teeheee/puzzle-box/layout/puzzlebox.ods

Id | Designator | Package | Quantity | Designation | Supplier and ref
23 | U1 | LQFP-48_7x7mm_P0.5mm | 1 | STM32F103C8Tx | https://www.reichelt.de/arm-cortex-m3-mikrocontroller-32-bit-2v-16-kb-lqfp-48-stm32f103c4t6a-p263735.html
25 | U3 | SOT-23-5 | 1 | MCP73831 | https://www.reichelt.de/battery-management-ic-li-ion-sot-23-5-mcp-73831t-2aci-p217314.html?trstct=pos_3
27 | U5 | Bosch_LGA-8_2.5x2.5mm_P0.65mm_ClockwisePinNumbering | 1 | BME280 | https://www.reichelt.de/kombo-sensor-luftdruck-luftfeuchtigkeit-temp-bme-280-p159825.html?trstct=pos_0
28 | U6 | LGA-12_2x2mm_P0.5mm | 1 | LSM303C | https://de.aliexpress.com/item/32954201739.html
31 | Q2,Q3,Q4 | BSS138 | 3 | Q_PMOS_DGS | https://www.reichelt.de/mosfet-p-ch-60v-0-33a-0-36w-sot-23-bss-83p-smd-p41442.html?&trstct=pos_0
