teeheee/puzzle-box/layout/stencil/puzzlebox-Edge.Cuts.dxf

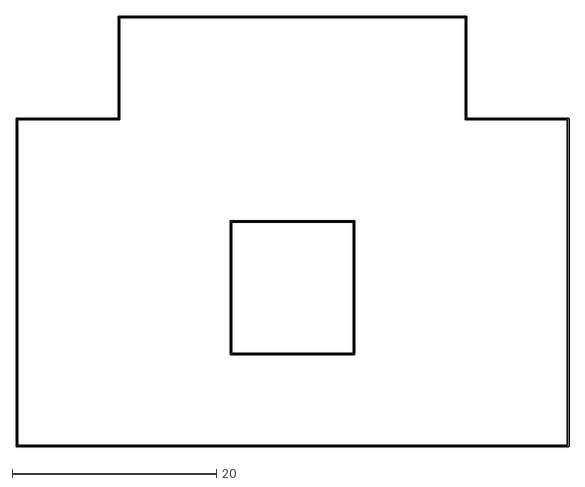
[picture p1: CAD file, 2019-11-30]
layout/stencil/puzzlebox-Edge.Cuts.dxf
54.2 x 42.2
