teeheee/puzzle-box/(list of files, cad)

Other CAD files:
layout/stencil/puzzlebox-B.Paste.dxf
layout/stencil/puzzlebox-F.Paste.dxf
