teeheee/puzzle-box/layout/puzzlebox.kicad_pcb

## KiCad design layout/puzzlebox.kicad_pcb (2019-11-03)

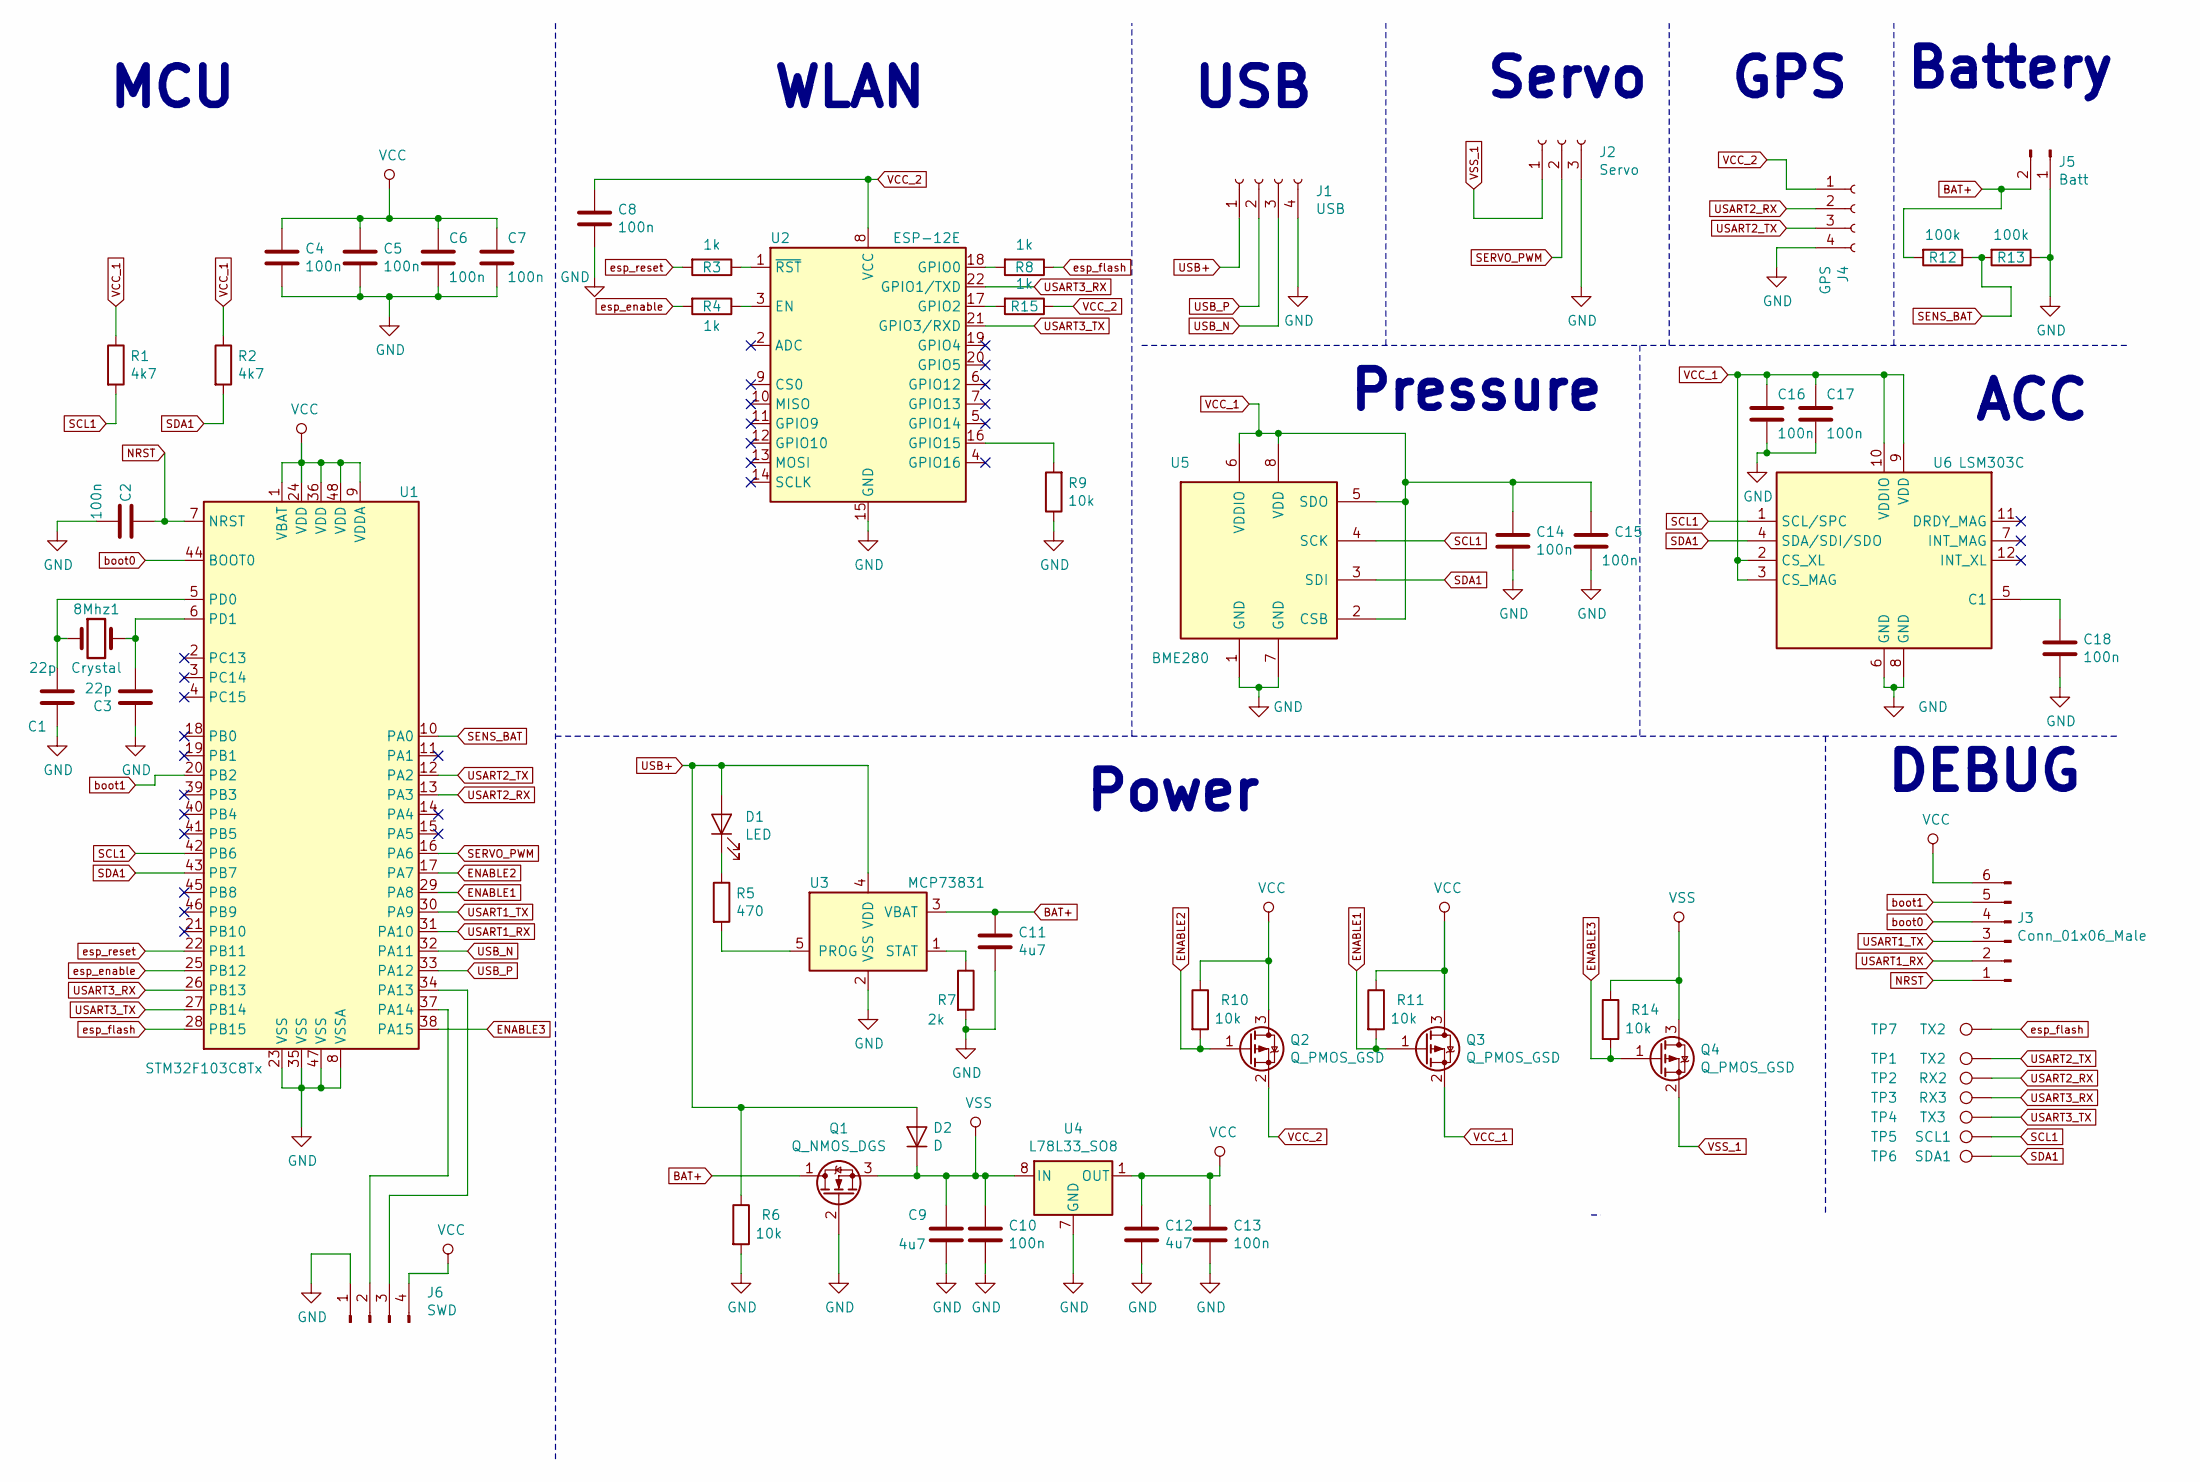
[picture p2: schematic puzzlebox.sch]

Parts:
8Mhz1: Crystal; Crystal_SMD_HC49-SD
C1, C3: 22p; C_0805_2012Metric
C2, C4, C5, C6, C7, C8, C10, C13, C14, C15, C16, C17, C18: 100n; C_0805_2012Metric
C9, C11, C12: 4u7; C_0805_2012Metric
D1: LED; LED_1206_3216Metric
D2: D; D_SOD-123
J1: USB; PinHeader_1x04_P1.00mm_Vertical
J2: Servo; PinHeader_1x03_P1.00mm_Vertical
J3: Conn_01x06_Male; PinHeader_2x03_P2.54mm_Vertical
J4: GPS; PinHeader_1x04_P1.00mm_Vertical
J5: Batt; PinHeader_1x02_P2.54mm_Vertical
J6: SWD; PinHeader_1x04_P2.00mm_Horizontal
Q1: Q_NMOS_DGS; BSS138
Q2, Q3, Q4: Q_PMOS_GSD; BSS138
R1, R2: 4k7; R_0805_2012Metric
R3, R4, R8, R15: 1k; R_0805_2012Metric
R5: 470; R_0805_2012Metric
R6, R9, R10, R11, R14: 10k; R_0805_2012Metric
R7: 2k; R_0805_2012Metric
R12, R13: 100k; R_0805_2012Metric
TP1, TP7: TX2; TestPoint_Pad_D2.0mm
TP2: RX2; TestPoint_Pad_D2.0mm
TP3: RX3; TestPoint_Pad_D2.0mm
TP4: TX3; TestPoint_Pad_D2.0mm
TP5: SCL1; TestPoint_Pad_D2.0mm
TP6: SDA1; TestPoint_Pad_D2.0mm
U1: STM32F103C8Tx; LQFP-48_7x7mm_P0.5mm
U2: ESP-12E
U3: MCP73831; SOT-23-5
U4: L78L33_SO8; SOIC-8_3.9x4.9mm_P1.27mm
U5: BME280; Bosch_LGA-8_2.5x2.5mm_P0.65mm_ClockwisePinNumbering
U6: LSM303C; LGA-12_2x2mm_P0.5mm

Connections:
BAT+: C11.1, J5.2, Q1.1 (D), R12.2, U3.3 (VBAT)
ENABLE1: Q3.1 (G), R11.2, U1.29 (PA8)
ENABLE2: Q2.1 (G), R10.2, U1.17 (PA7)
ENABLE3: Q4.1 (G), R14.2, U1.38 (PA15)
GND: C1.1, C2.2, C3.1, C4.2, C5.2, C6.2, C7.2, C8.2, C9.2, C10.2, C11.2, C12.2, C13.2, C14.2, C15.2, C16.2, C17.2, C18.2, J1.4, J2.3, J4.4, J5.1, J6.1, Q1.2 (G), R6.2, R7.2, R9.1, R13.1, U1.8 (VSSA), U1.23 (VSS), U1.35 (VSS), U1.47 (VSS), U2.15 (GND), U3.2 (VSS), U4.2 (GND), U4.3 (GND), U4.6 (GND), U4.7 (GND), U5.1 (GND), U5.7 (GND), U6.6 (GND), U6.8 (GND)
NRST: C2.1, J3.1, U1.7 (NRST)
unnamed: 8Mhz1.1, C1.2, U1.5 (PD0)
unnamed: 8Mhz1.2, C3.2, U1.6 (PD1)
unnamed: C18.1, U6.5 (C1)
unnamed: D1.1 (K), R5.1
unnamed: J6.2, U1.37 (PA14)
unnamed: J6.3, U1.34 (PA13)
unnamed: R3.1, U2.1 (~RST)
unnamed: R4.1, U2.3 (EN)
unnamed: R5.2, U3.5 (PROG)
unnamed: R7.1, U3.1 (STAT)
unnamed: R8.2, U2.18 (GPIO0)
unnamed: R9.2, U2.16 (GPIO15)
unnamed: R15.2, U2.17 (GPIO2)
SCL1: R1.2, TP5.1, U1.42 (PB6), U5.4 (SCK), U6.1 (SCL/SPC)
SDA1: R2.2, TP6.1, U1.43 (PB7), U5.3 (SDI), U6.4 (SDA/SDI/SDO)
SENS_BAT: R12.1, R13.2, U1.10 (PA0)
SERVO_PWM: J2.2, U1.16 (PA6)
USART1_RX: J3.2, U1.31 (PA10)
USART1_TX: J3.3, U1.30 (PA9)
USART2_RX: J4.2, TP2.1, U1.13 (PA3)
USART2_TX: J4.3, TP1.1, U1.12 (PA2)
USART3_RX: TP3.1, U1.26 (PB13), U2.22 (GPIO1/TXD)
USART3_TX: TP4.1, U1.27 (PB14), U2.21 (GPIO3/RXD)
USB+: D1.2 (A), D2.2 (A), J1.1, R6.1, U3.4 (VDD)
USB_N: J1.3, U1.32 (PA11)
USB_P: J1.2, U1.33 (PA12)
VCC: C4.1, C5.1, C6.1, C7.1, C12.1, C13.1, J3.6, J6.4, Q2.3 (D), Q3.3 (D), R10.1, R11.1, U1.1 (VBAT), U1.9 (VDDA), U1.24 (VDD), U1.36 (VDD), U1.48 (VDD), U4.1 (OUT)
VCC_1: C14.1, C15.1, C16.1, C17.1, Q3.2 (S), R1.1, R2.1, U5.2 (CSB), U5.5 (SDO), U5.6 (VDDIO), U5.8 (VDD), U6.2 (CS_XL), U6.3 (CS_MAG), U6.9 (VDD), U6.10 (VDDIO)
VCC_2: C8.1, J4.1, Q2.2 (S), R15.1, U2.8 (VCC)
VSS: C9.1, C10.1, D2.1 (K), Q1.3 (S), Q4.3 (D), R14.1, U4.8 (IN)
VSS_1: J2.1, Q4.2 (S)
boot0: J3.4, U1.44 (BOOT0)
boot1: J3.5, U1.20 (PB2)
esp_enable: R4.2, U1.25 (PB12)
esp_flash: R8.1, TP7.1, U1.28 (PB15)
esp_reset: R3.2, U1.22 (PB11)

Notes on the sheet:
WLAN
GPS
MCU
Battery
USB
Power
Pressure
Servo
ACC
DEBUG

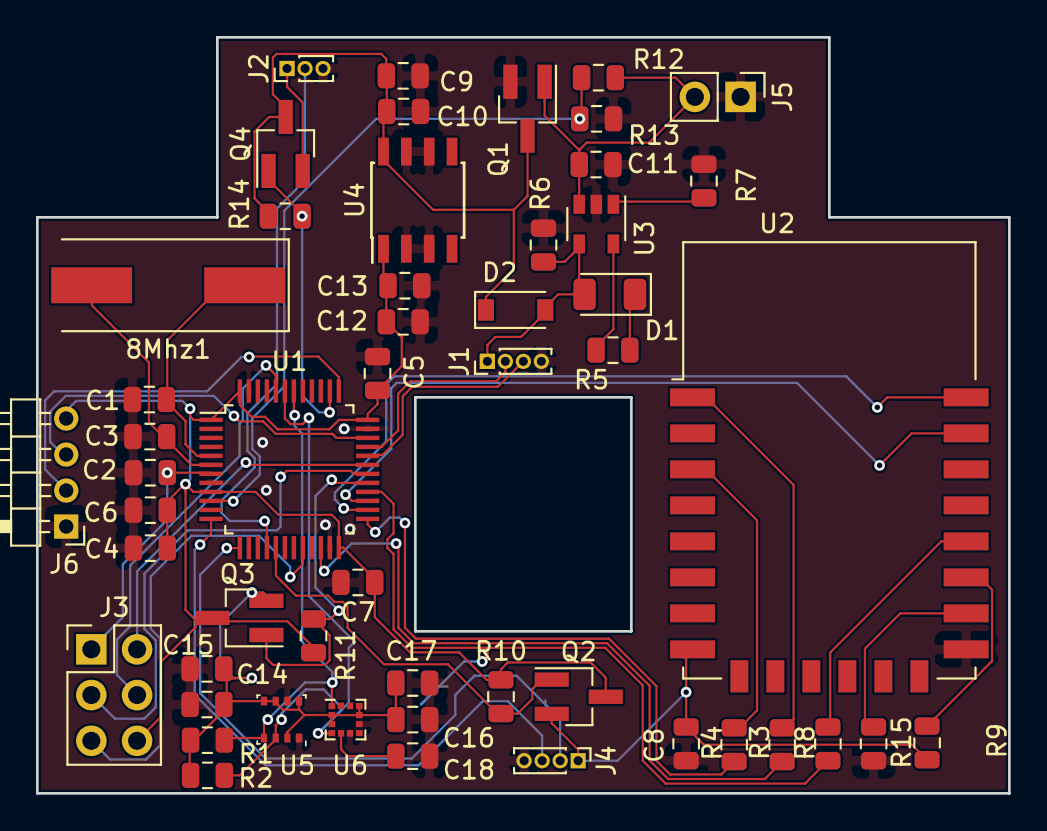
[picture p3: board puzzlebox.kicad_pcb from above]

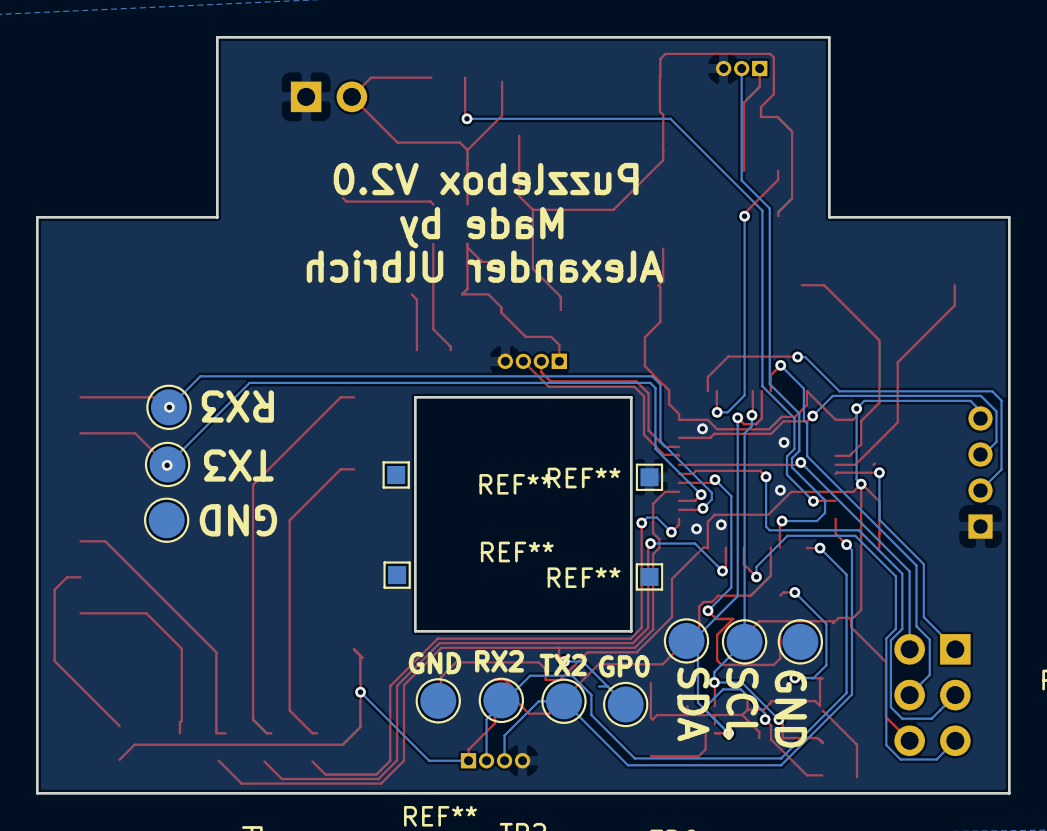
[picture p4: board puzzlebox.kicad_pcb from below]

Board: 2 copper layers, 54.0 x 42.0 mm, 59 parts (7 on the bottom side), 42 nets.
