teeheee/puzzle-box/(threads)

Thread 1 (2019-12-22):

voltage regulater package problem

teeheee, 2019-12-22:
The voltage regulator U4 has the wrong pinout of the package. This issue can be fixed by scraping off the ground connection and soldering a bridge between pin 4 and 5.

TODO: When doing this also update the part naming

Thread 2 (2019-12-22):

esp8266 uart connected wrong

teeheee, 2019-12-22:
The usart3 is connected to the wrong pins of the stm32 mcu.
