teeheee/puzzle-box/firmware/stm32/Src/main.c

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

/* Includes ------------------------------------------------------------------*/
#include "main.h"

ADC_HandleTypeDef hadc1;

I2C_HandleTypeDef hi2c1;

UART_HandleTypeDef huart1;
UART_HandleTypeDef huart2;

void SystemClock_Config(void);
static void MX_GPIO_Init(void);
static void MX_ADC1_Init(void);
static void MX_I2C1_Init(void);
static void MX_USART1_UART_Init(void);
static void MX_USART2_UART_Init(void);
/* USER CODE BEGIN PFP */

void open(void);
void close(void);
void enable_esp8266(void);

/* USER CODE END PFP */

/* USER CODE BEGIN 0 */

void open(void)
{
	HAL_GPIO_WritePin(GPIOA, GPIO_PIN_15, GPIO_PIN_RESET);
    HAL_Delay(100);
    for(int i = 0; i < 50; i++)
    {
		HAL_GPIO_WritePin(GPIOA, GPIO_PIN_6, GPIO_PIN_SET);
	    HAL_Delay(2);
		HAL_GPIO_WritePin(GPIOA, GPIO_PIN_6, GPIO_PIN_RESET);
	    HAL_Delay(18);
    }
	HAL_GPIO_WritePin(GPIOA, GPIO_PIN_15, GPIO_PIN_SET);
}


void close(void)
{
	HAL_GPIO_WritePin(GPIOA, GPIO_PIN_15, GPIO_PIN_RESET);
    HAL_Delay(100);
    for(int i = 0; i < 50; i++)
    {
		HAL_GPIO_WritePin(GPIOA, GPIO_PIN_6, GPIO_PIN_SET);
	    HAL_Delay(1);
		HAL_GPIO_WritePin(GPIOA, GPIO_PIN_6, GPIO_PIN_RESET);
	    HAL_Delay(19);
    }
	HAL_GPIO_WritePin(GPIOA, GPIO_PIN_15, GPIO_PIN_SET);
}

void enable_esp8266(void)
{
	HAL_GPIO_WritePin(GPIOB, GPIO_PIN_11, GPIO_PIN_RESET);
	HAL_GPIO_WritePin(GPIOB, GPIO_PIN_12, GPIO_PIN_SET);
	HAL_GPIO_WritePin(GPIOB, GPIO_PIN_15, GPIO_PIN_SET);
}

void process_esp8266_uart(void)
{
	const char* code = "open";
	static int index = 0;
	uint8_t buffer;
    HAL_UART_Receive(&huart2, &buffer, 1, HAL_MAX_DELAY);
    if(code[index] == buffer)
    	index++;
    else if(code[0] == buffer)
    	index = 1;
    else
    	index = 0;

    if(index == 3)
    	open();
}

/* USER CODE END 0 */

/**
  * @brief  The application entry point.
  * @retval int
  */
int main(void)
{
  

  /* MCU Configuration--------------------------------------------------------*/

  /* Reset of all peripherals, Initializes the Flash interface and the Systick. */
  HAL_Init();

  /* Configure the system clock */
  SystemClock_Config();

  /* Initialize all configured peripherals */
  MX_GPIO_Init();
  MX_ADC1_Init();
  MX_I2C1_Init();
  MX_USART1_UART_Init();
  MX_USART2_UART_Init();
  /* USER CODE BEGIN 2 */
  close();
  enable_esp8266();
  /* USER CODE END 2 */

  /* Infinite loop */
  /* USER CODE BEGIN WHILE */
  while (1)
  {
	  /* USER CODE END WHILE */
	  process_esp8266_uart();
	  /* USER CODE BEGIN 3 */
  }
  /* USER CODE END 3 */
}

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
