teeheee/puzzle-box/(commit log)

2019-11-03 finished V2.0 for production
    [puzzlebox-B.Cu.gbr, puzzlebox-B.Mask.gbr, puzzlebox-B.Paste.gbr, puzzlebox-B.SilkS.gbr, puzzlebox-Edge.Cuts.gbr, puzzlebox-F.Cu.gbr, puzzlebox-F.Mask.gbr, puzzlebox-F.Paste.gbr]
2019-11-03 changed layoutname
    [puzzlebox-B.Cu.gbr, puzzlebox-B.Mask.gbr, puzzlebox-B.Paste.gbr, puzzlebox-B.SilkS.gbr, puzzlebox-Edge.Cuts.gbr, puzzlebox-F.Cu.gbr, puzzlebox-F.Mask.gbr, puzzlebox-F.Paste.gbr]
2019-11-30 added stencils and made the first programm that flashs
    [puzzlebox-B.Paste.dxf, puzzlebox-Edge.Cuts.dxf, puzzlebox-F.Paste.dxf, stencil.scad]
2019-12-22 changed stm32 enviroment to cubemx
    [puzzlebox Debug.cfg]
2019-12-22 stm32 first test version finished
    it can get open requests from esp8266 and open the lock with the servo.
    [puzzlebox Debug.cfg]
